aronkis/Licenta/Schematics/Components/74HCT08BQ,115/74HCT08BQ,115.step

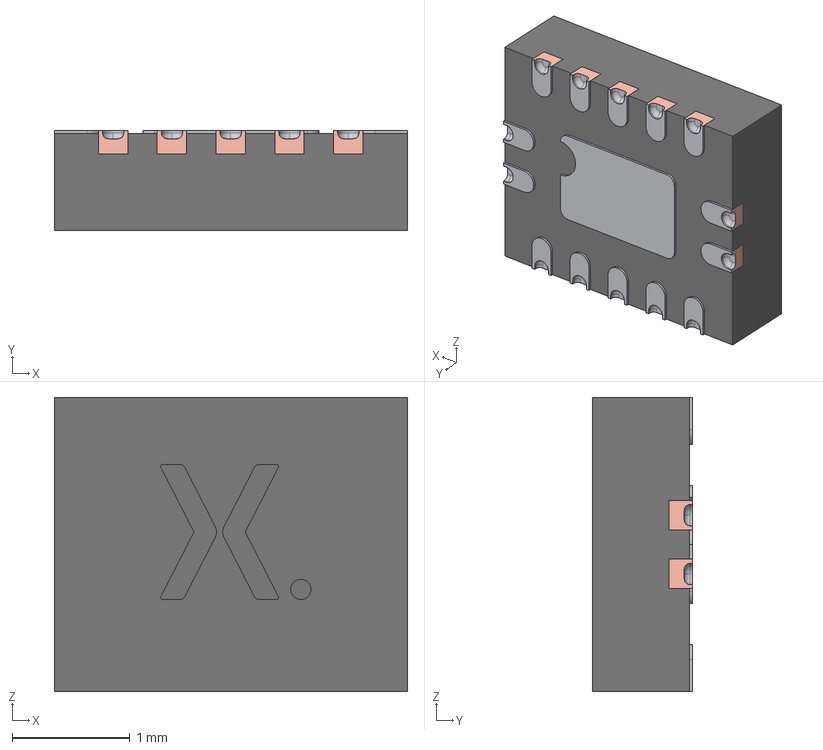
[picture p1: CAD file, 2024-04-26]
Schematics/Components/74HCT08BQ,115/74HCT08BQ,115.step
3.00 x 0.85 x 2.50 mm
SOT762 Body
SOT762 Heatsink
SOT762 Lead x 14
