aronkis/Licenta/Schematics/Components/8730/8730.step

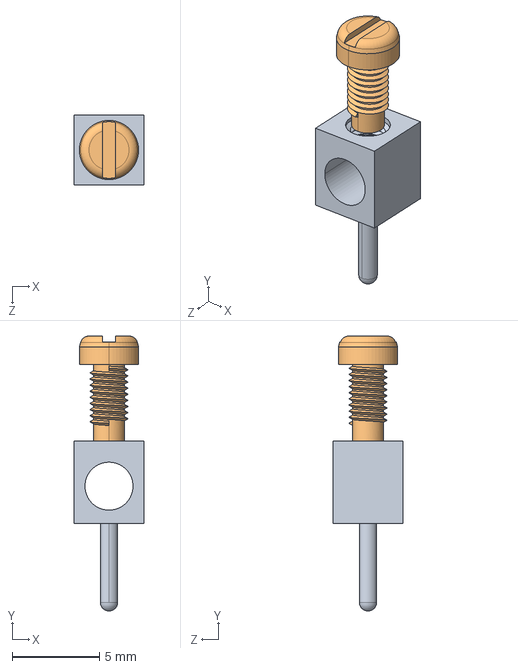
[picture p2: CAD file, 2024-06-25]
Schematics/Components/8730/8730.step
4.00 x 15.8 x 4.00 mm
