aronkis/Licenta/Schematics/Components/BSZ0902NS/BSZ0902NS.step

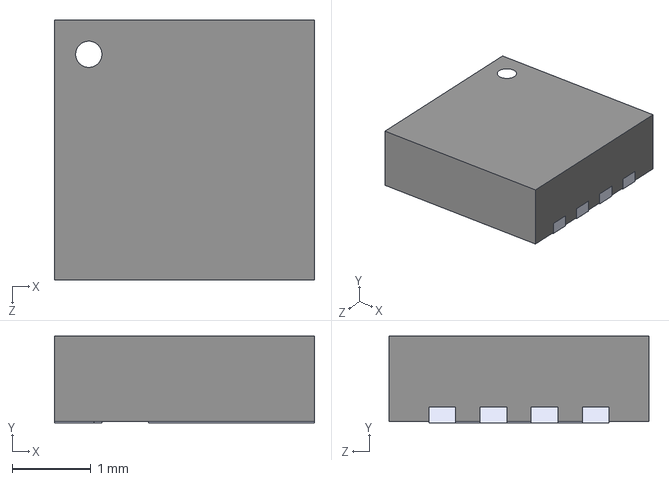
[picture p3: CAD file, 2024-06-25]
Schematics/Components/BSZ0902NS/BSZ0902NS.step
3.30 x 1.10 x 3.30 mm
