aronkis/Licenta/Schematics/Components/DRV8300DRGER/RGE0024B.stp

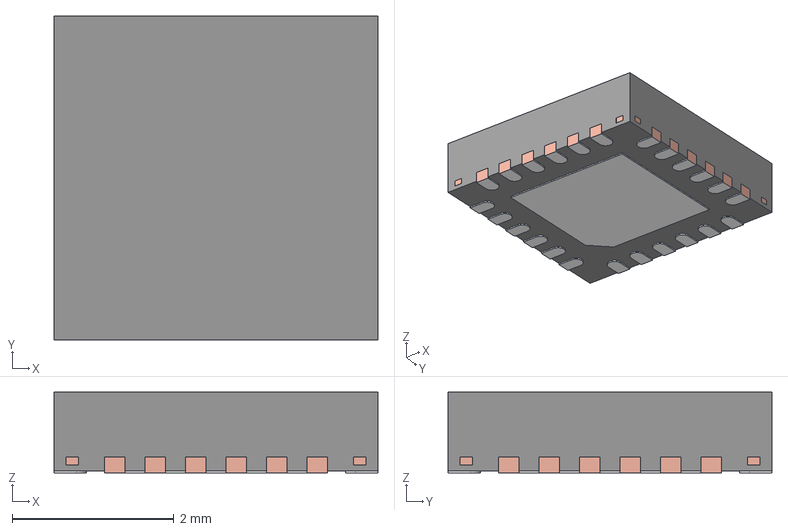
[picture p4: CAD file, 2024-06-25]
Schematics/Components/DRV8300DRGER/RGE0024B.stp
4.00 x 4.00 x 1.00 mm
BODY-QFN
FRAME-RGE0024B
PIN1-ID
