aronkis/Licenta/Schematics/Components/ECS_80_12_33_JGN_TR/ECS-80-12-33-JGN-TR.step

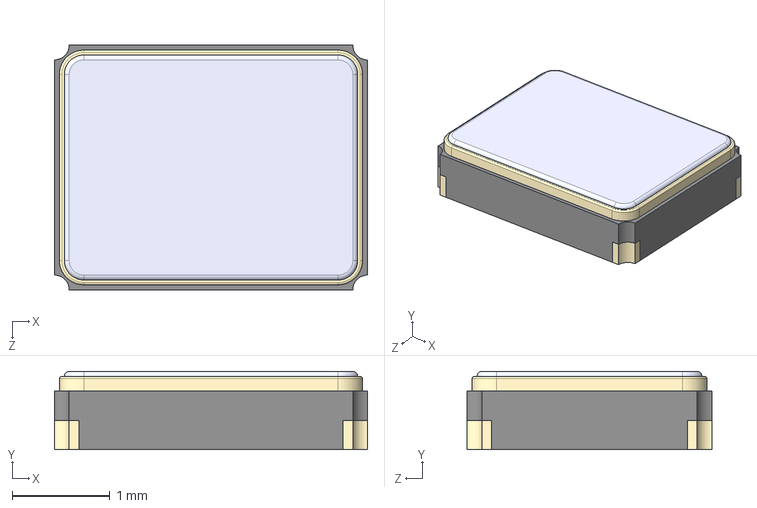
[picture p5: CAD file, 2024-06-25]
Schematics/Components/ECS_80_12_33_JGN_TR/ECS-80-12-33-JGN-TR.step
3.20 x 0.8 x 2.50 mm
