aronkis/Licenta/Schematics/Components/PTVS12VS1UTR-115/PTVS12VS1UTR-115.step

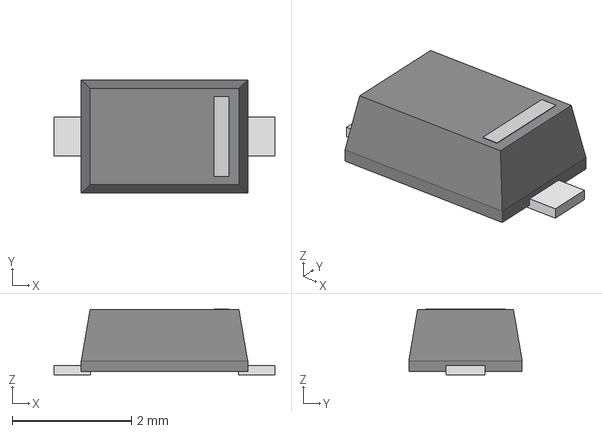
[picture p6: CAD file, 2024-06-25]
Schematics/Components/PTVS12VS1UTR-115/PTVS12VS1UTR-115.step
3.71 x 1.90 x 1.10 mm
