aronkis/Licenta/Schematics/Components/XZMDKVG55W-4/XZxxxx55W-4.step

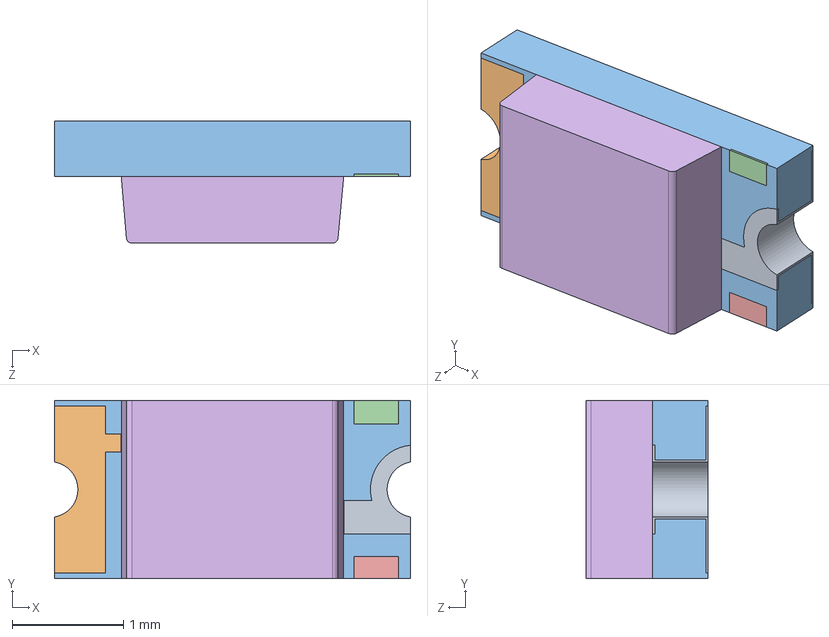
[picture p7: CAD file, 2024-06-25]
Schematics/Components/XZMDKVG55W-4/XZxxxx55W-4.step
3.20 x 1.60 x 1.10 mm
