aronkis/Licenta/Schematics/Components/TLV76750DRVR/TLV76750DRVR.stp

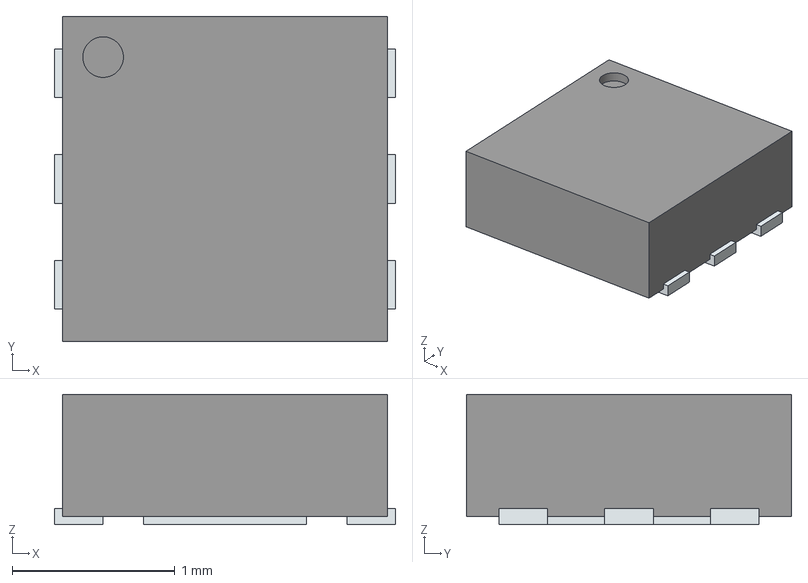
[picture p8: CAD file, 2024-04-29]
Schematics/Components/TLV76750DRVR/TLV76750DRVR.stp
2.10 x 2.00 x 0.8 mm
ThermalPin
PinsArrayLR
