aronkis/Licenta/Simulations/BEMF Filter/BEMF_Filter.asc

C3: cap; 2.2n
R1: res; 20k
R2: res; 33k
R3: res; 10k
V1: voltage; AC 1
Named nets: 0, BEMF
.ac dec 10m 1 50k
