aronkis/Licenta/Simulations/PWM Filter/PWM_Filter.asc

C1: cap; 47µ; Rser=0.002
C3: cap; 47µ
L1: ind; 100µ; Rpar=0.728
L2: ind; 100µ
R1: res; 30
V1: voltage; PULSE(0 5 0 100n 100n 5.2u 10u)
Named nets: 0, PWM_OUT
.tran 25m
