aronkis/Licenta/Schematics/esc.kicad_pcb

## KiCad design Schematics/esc.kicad_pcb (2024-06-30)

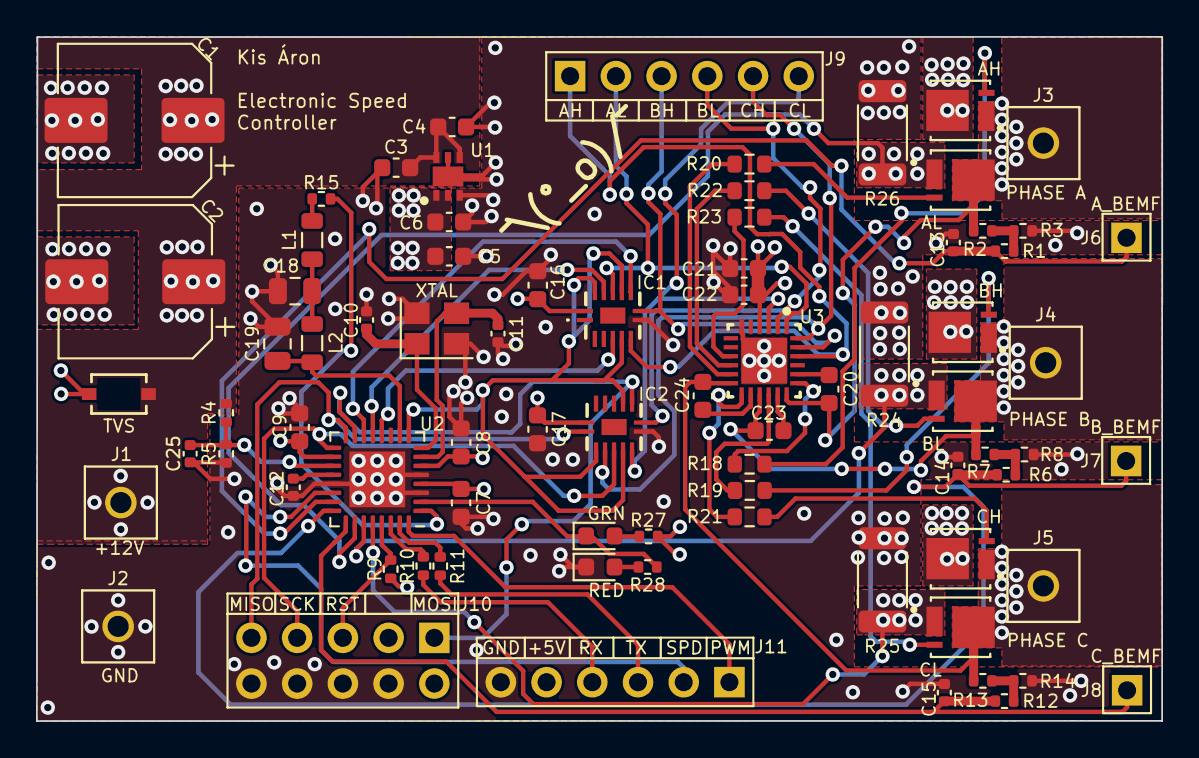
[picture p9: board esc.kicad_pcb from above]

Board: 4 copper layers, 62.5 x 38.0 mm, 79 parts (0 on the bottom side), 61 nets.

Parts:
AH: BSZ0902NS
AL: BSZ0902NS
BH: BSZ0902NS
BL: BSZ0902NS
C1, C2: 470u; CP_Elec_8x10
C3, C4, C22: 1u; C_0603_1608Metric
C5, C6: 2.2u; C_0603_1608Metric
C7, C8, C9, C16, C17: 100n; C_0603_1608Metric
C10, C11: 22p; C_0402_1005Metric
C12, C25: 100n; C_0402_1005Metric
C13, C14, C15: 2.2n; C_0402_1005Metric
C18, C19: 47uF; C_0805_2012Metric
C20, C21, C23, C24: 0.1u; C_0603_1608Metric
CH: BSZ0902NS
CL: BSZ0902NS
GRN: LED; LED_0603_1608Metric
IC1, IC2: 74HCT08BQ,115; 74HCT08BQ115
J1, J2, J3, J4, J5: 8730
J6, J7, J8: Conn_01x01; PinHeader_1x01_P2.54mm_Vertical
J9, J11: Conn_01x06; PinHeader_1x06_P2.54mm_Vertical
J10: AVR-ISP-10; PinHeader_2x05_P2.54mm_Vertical
L1, L2: 100uH; L_0805_2012Metric
R1, R6, R9, R12: 10k; R_0402_1005Metric
R2, R4, R7, R13: 33k; R_0402_1005Metric
R3, R8, R14: 20k; R_0402_1005Metric
R5: 7.5k; R_0402_1005Metric
R10, R11: 1k; R_0402_1005Metric
R15: 30; R_0402_1005Metric
R18, R19, R20, R21, R22, R23: 15; R_0603_1608Metric
R24, R25, R26: 5m; R_2010_5025Metric
R27, R28: 300; R_0402_1005Metric
RED: LED; LED_0603_1608Metric
TVS: PTVS12VS1UTR_115; CR_1UTR_115_NEX
U1: TLV76750DRVx; SON65P200X200X80-7N
U2: ATmega328P-M; QFN-32-1EP_5x5mm_P0.5mm_EP3.1x3.1mm
U3: DRV8300DRGER; RGE0024B-IPC_C
XTAL: ECS-80-12-33-JGN-TR; Crystal_SMD_3225-4Pin_3.2x2.5mm

Connections:
+5V: C5.2, C6.2, C7.2, C8.2, C9.2, C16.1, C17.1, IC1.14 (VCC), IC2.14 (VCC), J10.2 (VCC), J11.5, R9.1, R27.1, U1.1 (OUT), U1.2 (SNS), U2.4 (VCC), U2.6 (VCC), U2.18 (AVCC)
+12V: AH.5_6_7_8, BH.5_6_7_8, C1.1, C2.1, C3.2, C4.2, C21.1, C22.2, CH.5_6_7_8, J1.1, R4.2, TVS.1, U1.4 (EN), U1.6 (IN), U3.4 (GVDD)
AH: IC1.4 (2A), U2.12 (PB0)
AH_PWM: IC1.6 (2Y), J9.1, U3.22 (INHA)
AL: IC1.12 (4A), U2.13 (PB1)
AL_PWM: IC1.11 (4Y), J9.2, U3.1 (INLA)
BH: IC1.9 (3A), U2.14 (PB2)
BH_PWM: IC1.8 (3Y), J9.3, U3.23 (INHB)
BL: IC2.9 (3A), J10.1 (MOSI), U2.15 (PB3)
BL_PWM: IC2.8 (3Y), J9.4, U3.2 (INLB)
CH: IC2.1 (1A), J10.9 (MISO), U2.16 (PB4)
CH_PWM: IC2.3 (1Y), J9.5, U3.24 (INHC)
CL: IC2.4 (2A), J10.7 (SCK), U2.17 (PB5)
CL_PWM: IC2.6 (2Y), J9.6, U3.3 (INLC)
COIL_A: AH.1_2_3, AL.5_6_7_8, C20.1, J3.1, R2.1, U3.18 (SHA)
COIL_A_BEMF: C13.2, J6.1, R1.1, U2.23 (PC0)
COIL_A_CURR: AL.1_2_3, R26.2, U2.26 (PC3)
COIL_B: BH.1_2_3, BL.5_6_7_8, C23.1, J4.1, R7.1, U3.15 (SHB)
COIL_B_BEMF: C14.2, J7.1, R6.1, U2.24 (PC1)
COIL_B_CURR: BL.1_2_3, R24.2, U2.27 (PC4)
COIL_C: C24.1, CH.1_2_3, CL.5_6_7_8, J5.1, R13.1, U3.12 (SHC)
COIL_C_BEMF: C15.2, J8.1, R12.1, U2.25 (PC2)
COIL_C_CURR: CL.1_2_3, R25.2, U2.28 (PC5)
COMP_REF_IN: C19.2, L2.2, U2.10 (PD6)
COMP_REF_OUT: R15.2, U2.1 (PD3)
GND: C1.2, C2.2, C3.1, C4.1, C5.1, C6.1, C7.1, C8.1, C9.1, C10.1, C11.1, C12.1, C13.1, C14.1, C15.1, C16.2, C17.2, C18.1, C19.1, C21.2, C22.1, C25.1, IC1.7 (GND_1), IC2.7 (GND_1), J2.1, J10.4 (GND), J10.6 (GND), J10.8 (GND), J10.10 (GND), J11.6, R3.1, R5.1, R8.1, R14.1, R24.1, R25.1, R26.1, RED.1 (K), TVS.2, U1.3 (GND), U1.5 (GND), U1.7 (PAD), U2.3 (GND), U2.5 (GND), U2.21 (GND), U2.33 (GND), U3.6 (GND), U3.25 (PowerPAD), XTAL.2, XTAL.4
LED: GRN.1 (K), R28.1, U2.2 (PD4)
unnamed: AH.4, R18.2
unnamed: AL.4, R20.2
unnamed: BH.4, R19.2
unnamed: BL.4, R22.2
unnamed: C18.2, L1.2, L2.1
unnamed: CH.4, R21.2
unnamed: CL.4, R23.2
unnamed: GRN.2 (A), R27.2
unnamed: L1.1, R15.1
unnamed: R1.2, R2.2, R3.2
unnamed: R6.2, R7.2, R8.2
unnamed: R12.2, R13.2, R14.2
unnamed: R28.2, RED.2 (A)
unnamed: C12.2, U2.20 (AREF)
unnamed: R10.2, U2.30 (PD0)
unnamed: R11.2, U2.31 (PD1)
unnamed: C20.2, U3.20 (BSTA)
unnamed: C23.2, U3.17 (BSTB)
unnamed: C24.2, U3.14 (BSTC)
unnamed: R18.1, U3.19 (GHA)
unnamed: R19.1, U3.16 (GHB)
unnamed: R21.1, U3.13 (GHC)
unnamed: R20.1, U3.11 (GLA)
unnamed: R22.1, U3.10 (GLB)
unnamed: R23.1, U3.9 (GLC)
PWM_IN: J11.1, U2.32 (PD2)
PWM_OUT: IC1.5 (2B), IC1.10 (3B), IC1.13 (4B), IC2.2 (1B), IC2.5 (2B), IC2.10 (3B), U2.9 (PD5)
RST: J10.5 (~RST), R9.2, U2.29 (~RESET/PC6)
RX: J11.4, R10.1
SPEED_REF: J11.2, U2.22 (ADC7)
TX: J11.3, R11.1
VBUS: C25.2, R4.1, R5.2, U2.19 (ADC6)
XTAL1: C11.2, U2.7 (XTAL1/PB6), XTAL.3
XTAL2: C10.2, U2.8 (XTAL2/PB7), XTAL.1
