aronkis/Licenta/(commit log)

2024-04-26 Saving files to git
    [150121M173000.stp, 744045222.stp, 74651174.stp, 74HCT08BQ,115.step, AZ1084CD-3-3TRG1.step, BOM.xlsx, BSZ0902NS.step, BUK9Y3R0-40E_115.step]
2024-04-29 New connectors, and BEMF Filter.
    [8730.step, ECS-80-12-33-JGN-TR.step, TLV76750DRVR.stp, connectors.kicad_sch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]
2024-04-30 VIA update
    [SDR0503_332JL.stp, esc.kicad_pcb, high_voltage_sch.kicad_sch, low_voltage_sch.kicad_sch]
2024-05-01 swaped PWM_IN & Comp_Ref_Out, vias finished
    [connectors.kicad_sch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]
2024-05-04 Added pins for the BACK-EMFs and PWM Control signals
    [connectors.kicad_sch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]
2024-05-05 Changed 8MHz to XTAL (might use 16MHz)
    [esc.kicad_pcb]
2024-05-07 Added VBUS measurment.
    [esc.kicad_pcb]
2024-05-07 Ready to order(?)
    [connectors.kicad_sch, esc.kicad_pcb, high_voltage_sch.kicad_sch, low_voltage_sch.kicad_sch]
2024-05-08 Ready to order.
    [ESC_BOM.csv, connectors.kicad_sch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]
2024-05-09 2 Layers Current Resistor connection.
    [esc-B_Mask.gbs, esc-B_Paste.gbp, esc-B_Silkscreen.gbo, esc-Bottom.gbl, esc-Edge_Cuts.gm1, esc-F_Mask.gts, esc-F_Paste.gtp, esc-F_Silkscreen.gto]
2024-05-10 Changing the VD Resistors to 3.33k.
    [high_voltage_sch.kicad_sch]
2024-05-13 redoing the adc triggers/interupt routine.
2024-05-23 Timer1 calibration.
2024-05-26 Timer2 setup.
2024-05-30 Saving current progress with adc interrupt.
2024-06-18 Motor speed stabilized.
2024-06-23 Before adding motor stop/restart functionality.
2024-06-25 Cleaning up.
    [150121M173000.stp, 744045222.stp, 74651174.stp, 74HCT08BQ,115.step, 8730.step, AZ1084CD-3-3TRG1.step, BOM.xlsx, BSZ0902NS.step]
2024-07-01 Stall detection and speed calculation update.
    [functions.c, functions.h, interrupts.c, interrupts.h]
2024-07-03 Sampling option and removing unused components.
    [150121M173000.stp, 744045222.stp, 74651174.stp, AZ1084CD-3-3TRG1.step, BUK9Y3R0-40E_115.step, ECS-160-20-20A-TR.step, ECS-80-12-30BQ-JES-TR.step, SDR0503_332JL.stp]
